OsloMet-GreenEnergyLab/EPS-subsonic-jet-facility/3d models/readyToPrint/Smoke holder design.3mf

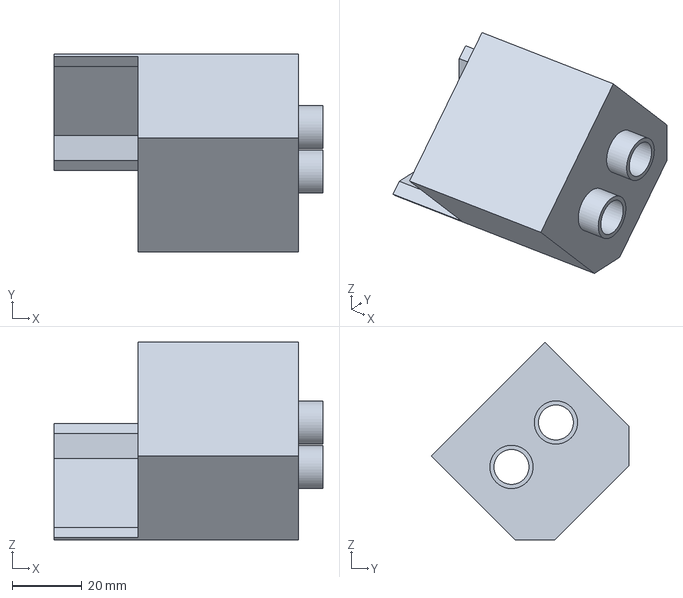
[picture p3: CAD file, 2025-06-10]
3d models/readyToPrint/Smoke holder design.3mf
77.0 x 56.6 x 56.6 mm
