OsloMet-GreenEnergyLab/EPS-subsonic-jet-facility/3d models/readyToPrint/Acoustic nozzle mount.3mf

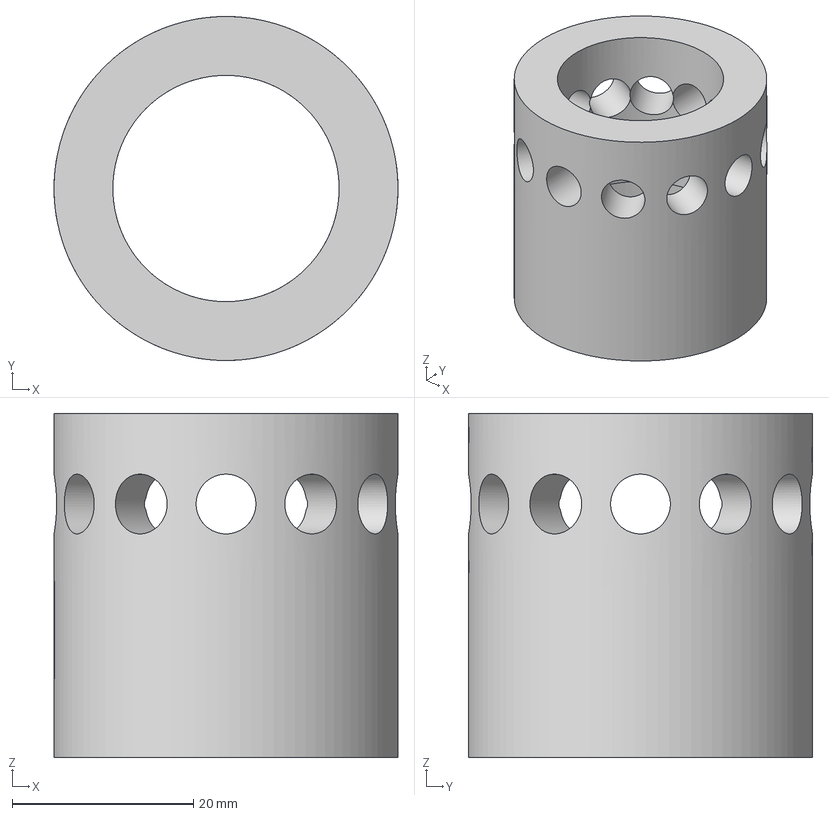
[picture p4: CAD file, 2025-06-10]
3d models/readyToPrint/Acoustic nozzle mount.3mf
38.0 x 38.0 x 38.0 mm
