OsloMet-GreenEnergyLab/EPS-subsonic-jet-facility/3d models/readyToPrint/ControlPanelBox version2.STL

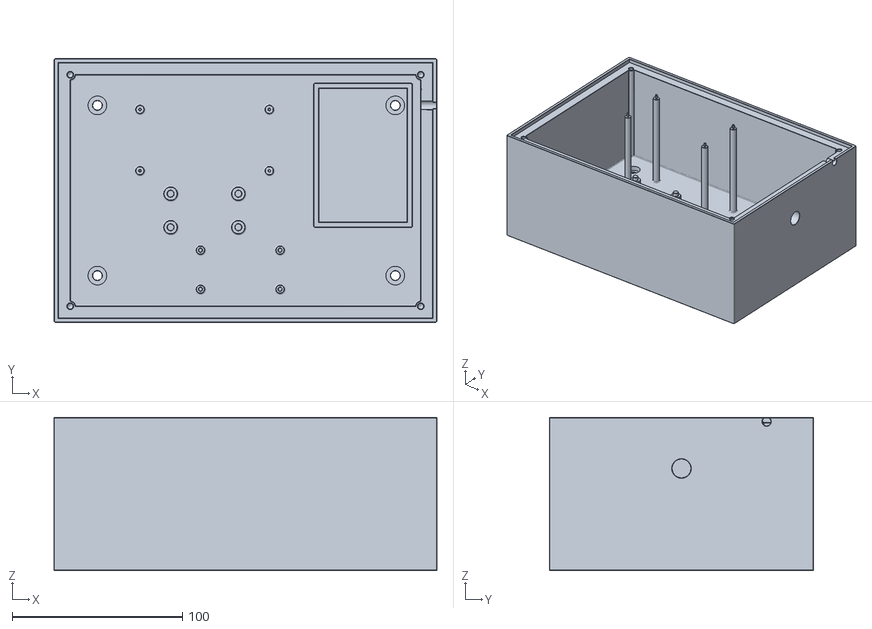
[picture p5: CAD file, 2025-06-10]
3d models/readyToPrint/ControlPanelBox version2.STL
225.0 x 155.0 x 90.0
