OsloMet-GreenEnergyLab/EPS-subsonic-jet-facility/3d models/readyToPrint/Smoker around nozzle.3mf

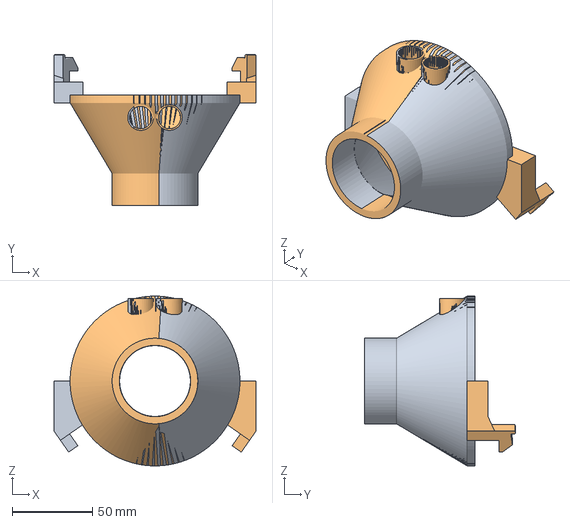
[picture p6: CAD file, 2025-06-10]
3d models/readyToPrint/Smoker around nozzle.3mf
126.1 x 94.2 x 106.0 mm
