OsloMet-GreenEnergyLab/EPS-subsonic-jet-facility/(list of files, cad)

Other CAD files:
3d models/readyToPrint/Amp bracket.gcode.3mf
3d models/readyToPrint/potentiometer caps.gcode.3mf
3d models/readyToPrint/Smoke fan intake.gcode.3mf
3d models/models/Acoustic nozzle mount.f3d
3d models/models/Smoker around Nozzle.f3d
