OsloMet-GreenEnergyLab/EPS-subsonic-jet-facility/Circuit design/Circuit version4.pdf

12V

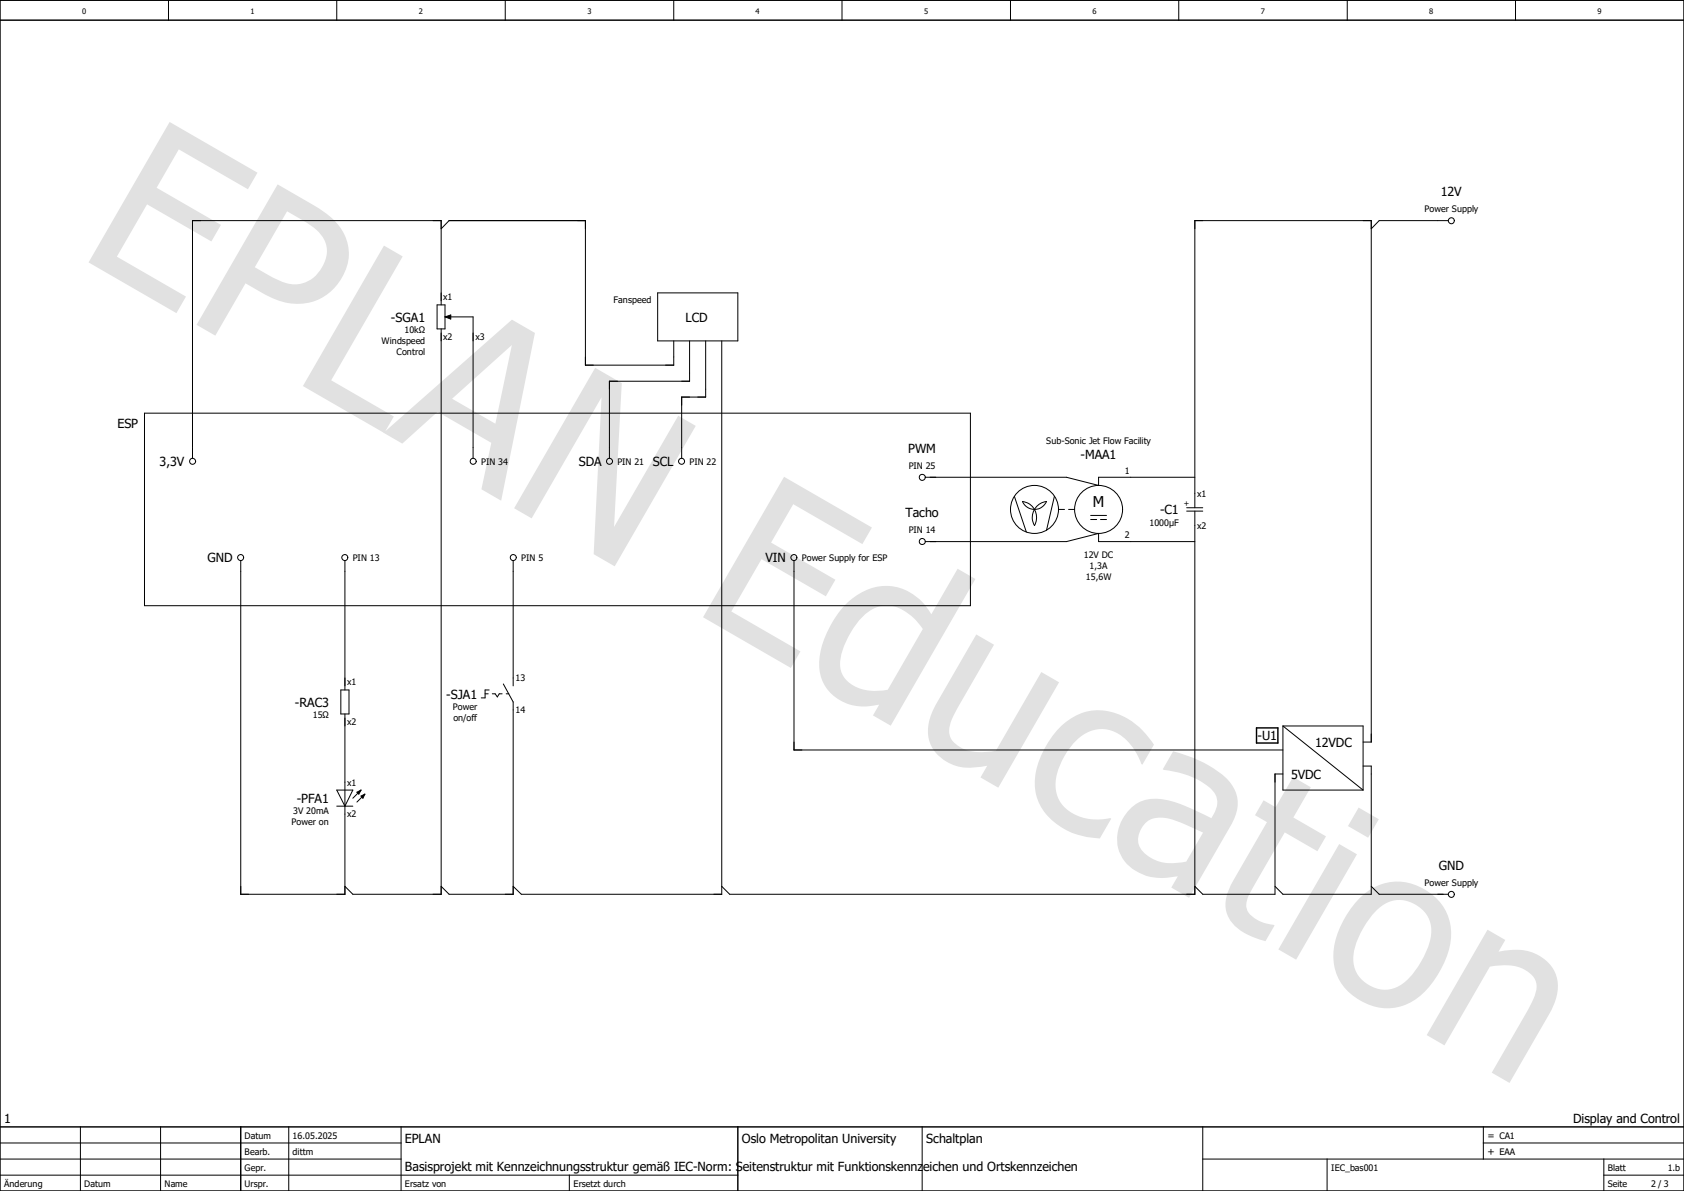
[picture p7: page 1]
12VDC; 5VDC; LCD; -SJA1 Power on/off; -PFA1 3V 20mA Power on; Power Supply; -SGA1 10kΩ Windspeed Control; GND; PIN 13; PIN 5; PIN 34; PIN 25; PWM; PIN 14; Tacho; -RAC3 15Ω; ESP; Fanspeed

Sub-Sonic Jet Flow Facility
-MAA1

SDA PIN 21 SCL PIN 22

VIN Power Supply for ESP

Display and Control

Datum | 16.05.2025 Oslo Metropolitan University | EPLAN Basisprojekt mit Kennzeichnungsstruktur gemäß IEC-Norm: Seitenstruktur mit Funktionskennzeichen und Ortskennzeichen | | Schaltplan | = CA1
Bearb. | dittm | | | | + EAA
Gepr. | | | | | IEC_bas001 | Blatt 1.b

Änderung | Datum | Name | Urspr. | | Ersatz von | Ersetzt durch | | | | Seite 2 / 3
