OsloMet-GreenEnergyLab/EPS-subsonic-jet-facility/(commit log)

2025-04-24 some ready to print 3d models
    [Smoke moduleFan intake.gcode.3mf, potentiometer caps.gcode.3mf]
2025-04-28 I2C pins added to pinout
2025-05-14 adjusted switches to be able to process default up or down signals
2025-05-14 fixed switch
2025-05-14 fixed fan stuttering
2025-06-10 added new 3d models, worksheet, circuit design
    [Amp bracket.gcode.3mf, ControlPanelBox version2.STL, Smoke fan intake.gcode.3mf, Smoke moduleFan intake.gcode.3mf, Smoker around nozzle.3mf]
2025-06-10 more 3d models
    [Acoustic nozzle mount.3mf, Smoke holder design.3mf]
2025-06-10 circuit design + worksheet
    [Acoustic nozzle mount.f3d, Smoker around Nozzle.f3d]
